JanFrederick00/VectrexV/schematic.pdf

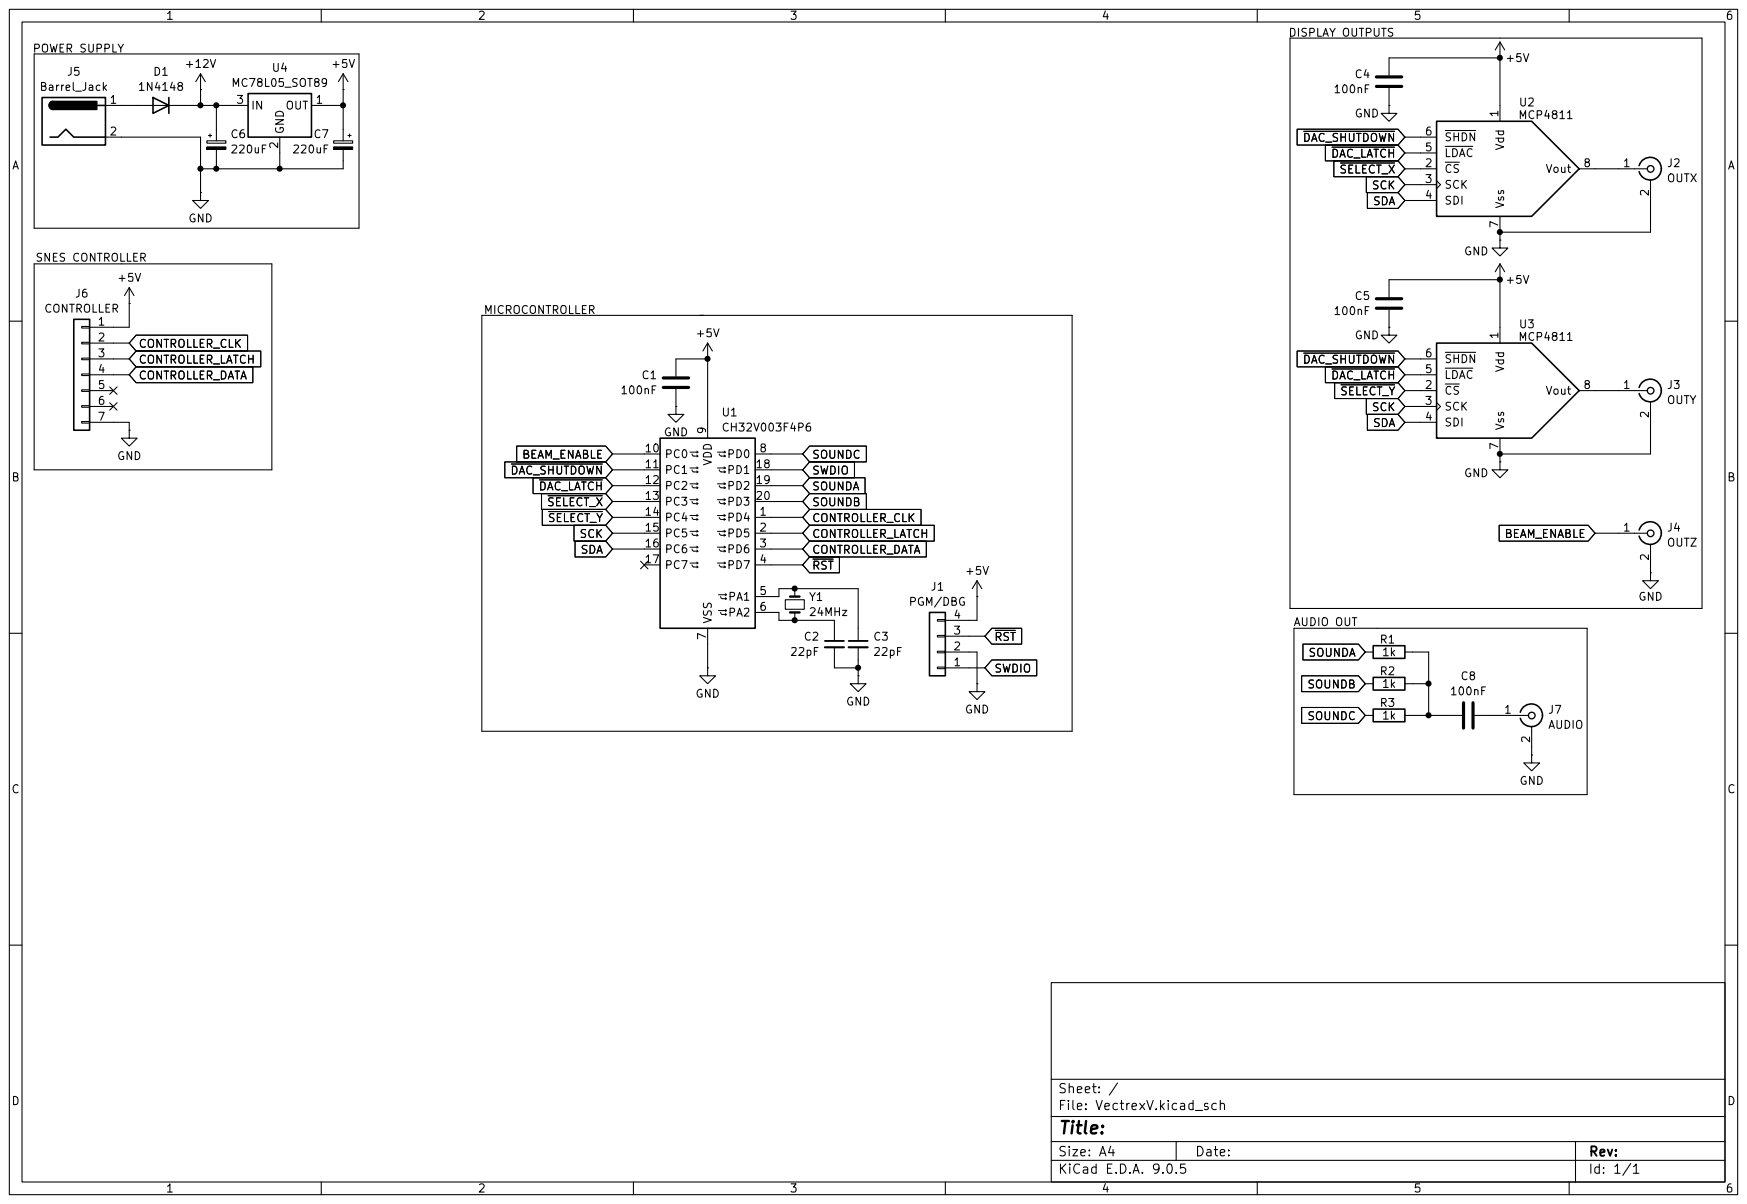
[picture p1: page 1]
