JanFrederick00/VectrexV/VectrexV.kicad_pcb

## KiCad design VectrexV.kicad_pcb (2026-11-04)

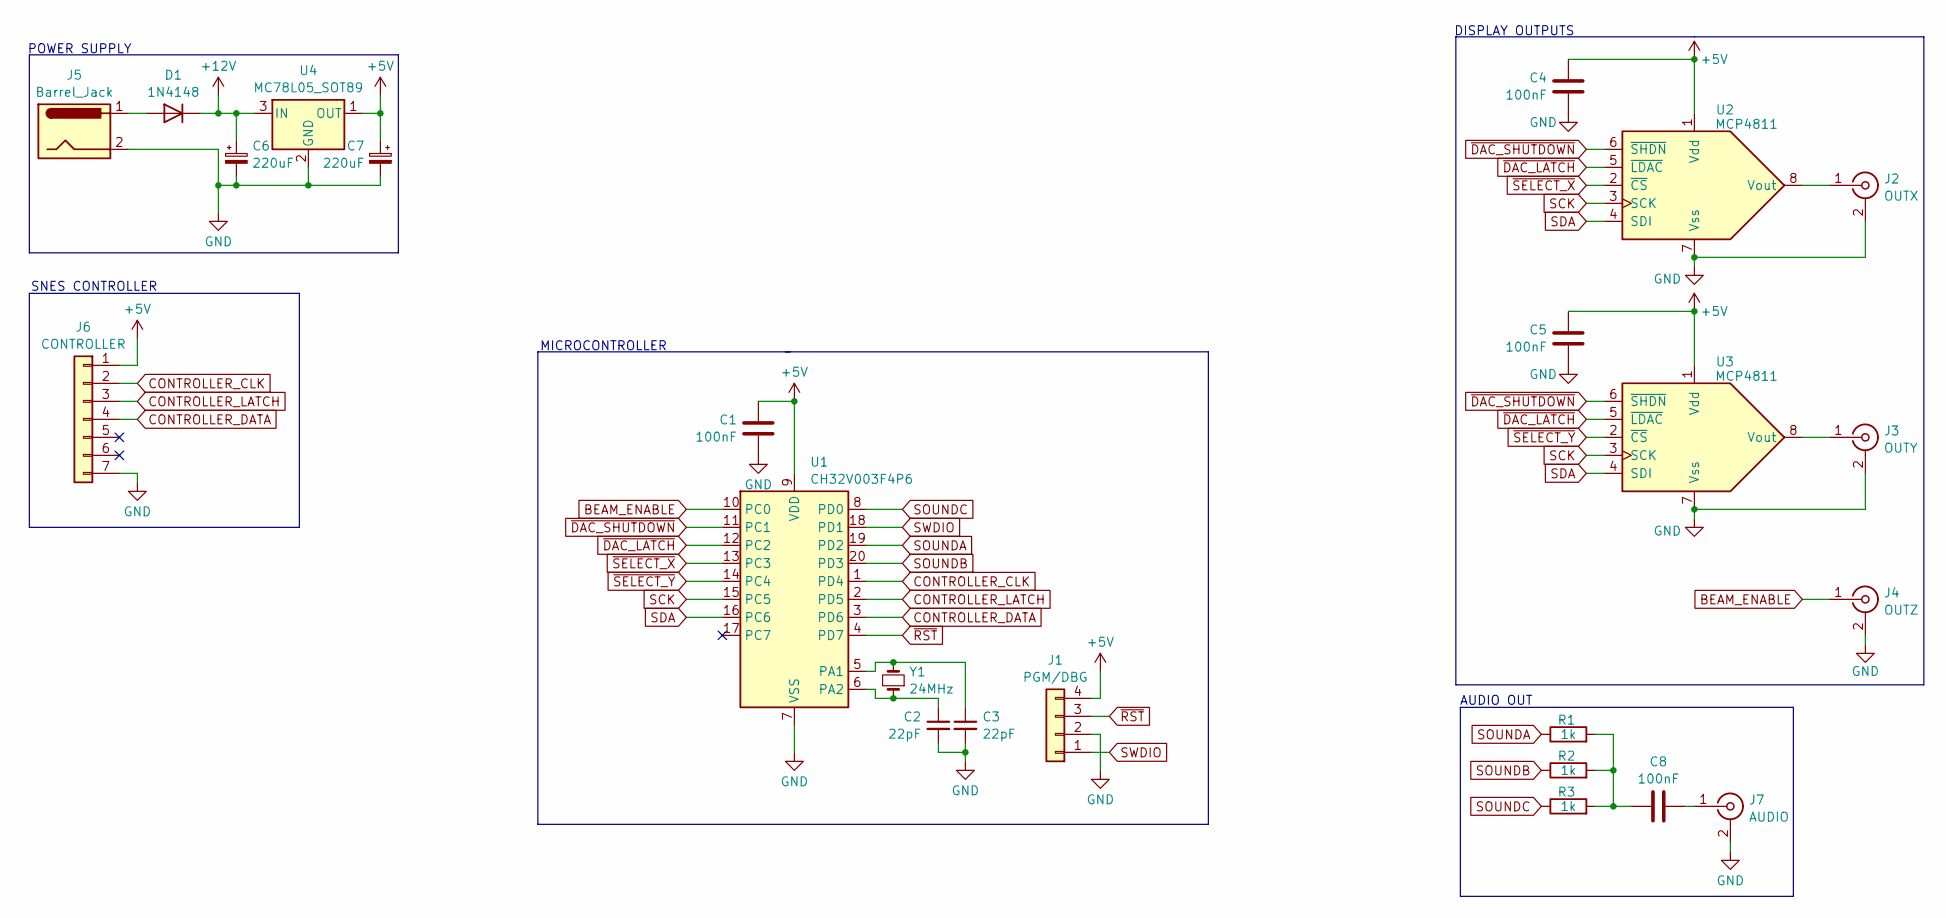
[picture p2: schematic VectrexV.kicad_sch]

Parts:
C1, C4, C5, C8: 100nF; C_0805_2012Metric_Pad1.18x1.45mm_HandSolder
C2, C3: 22pF; C_0805_2012Metric_Pad1.18x1.45mm_HandSolder
C6, C7: 220uF; CP_Radial_D5.0mm_P2.50mm
D1: 1N4148; D_DO-35_SOD27_P7.62mm_Horizontal
J1: PGM/DBG; PinHeader_1x04_P2.54mm_Vertical
J2: OUTX; RCA-jack
J3: OUTY; RCA-jack
J4: OUTZ; RCA-jack
J5: Barrel_Jack; BarrelJack_Horizontal
J6: CONTROLLER; PinHeader_1x07_P2.54mm_Vertical
J7: AUDIO; RCA-jack
R1, R2, R3: 1k; R_0805_2012Metric_Pad1.20x1.40mm_HandSolder
U1: CH32V003F4P6; TSSOP-20_4.4x6.5mm_P0.65mm
U2, U3: MCP4811; MSOP-8_3x3mm_P0.65mm
U4: MC78L05_SOT89; SOT-89-3
Y1: 24MHz; Crystal_HC50_Vertical

Connections:
+5V: C1.1, C4.1, C5.1, C7.1, J1.4, J6.1, U1.9 (VDD), U2.1 (Vdd), U3.1 (Vdd), U4.1 (OUT)
+12V: C6.1, D1.1 (K), U4.3 (IN)
BEAM_ENABLE: J4.1 (In), U1.10 (PC0)
CONTROLLER_CLK: J6.2, U1.1 (PD4)
CONTROLLER_DATA: J6.4, U1.3 (PD6)
CONTROLLER_LATCH: J6.3, U1.2 (PD5)
GND: C1.2, C2.2, C3.2, C4.2, C5.2, C6.2, C7.2, J1.2, J2.2 (Ext), J3.2 (Ext), J4.2 (Ext), J5.2, J6.7, J7.2 (Ext), U1.7 (VSS), U2.7 (Vss), U3.7 (Vss), U4.2 (GND)
unnamed: C8.1, R1.2, R2.2, R3.2
unnamed: D1.2 (A), J5.1
unnamed: J2.1 (In), U2.8 (Vout)
unnamed: J3.1 (In), U3.8 (Vout)
unnamed: C8.2, J7.1 (In)
unnamed: C3.1, U1.5 (PA1), Y1.2
unnamed: C2.1, U1.6 (PA2), Y1.1
SCK: U1.15 (PC5), U2.3 (SCK), U3.3 (SCK)
SDA: U1.16 (PC6), U2.4 (SDI), U3.4 (SDI)
SOUNDA: R1.1, U1.19 (PD2)
SOUNDB: R2.1, U1.20 (PD3)
SOUNDC: R3.1, U1.8 (PD0)
SWDIO: J1.1, U1.18 (PD1)
~DAC_LATCH: U1.12 (PC2), U2.5 (~LDAC), U3.5 (~LDAC)
~DAC_SHUTDOWN: U1.11 (PC1), U2.6 (~SHDN), U3.6 (~SHDN)
~RST: J1.3, U1.4 (PD7)
~SELECT_X: U1.13 (PC3), U2.2 (~CS)
~SELECT_Y: U1.14 (PC4), U3.2 (~CS)

Notes on the sheet:
POWER SUPPLY
MICROCONTROLLER
SNES CONTROLLER
AUDIO OUT
DISPLAY OUTPUTS

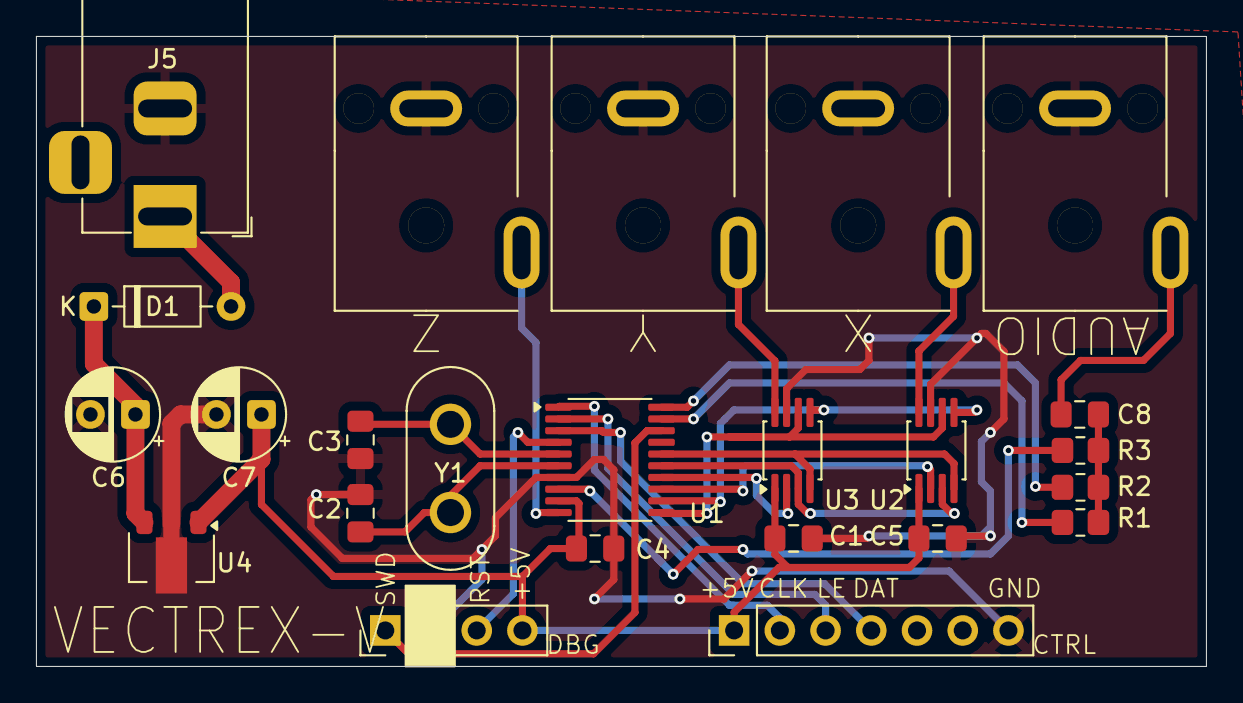
[picture p3: board VectrexV.kicad_pcb from above]

Board: 2 copper layers, 65.0 x 35.0 mm, 24 parts (0 on the bottom side), 25 nets.
